greggdaug/hf_switch_matrix/hf_swmat_design_wb6yaz_041022.pdf

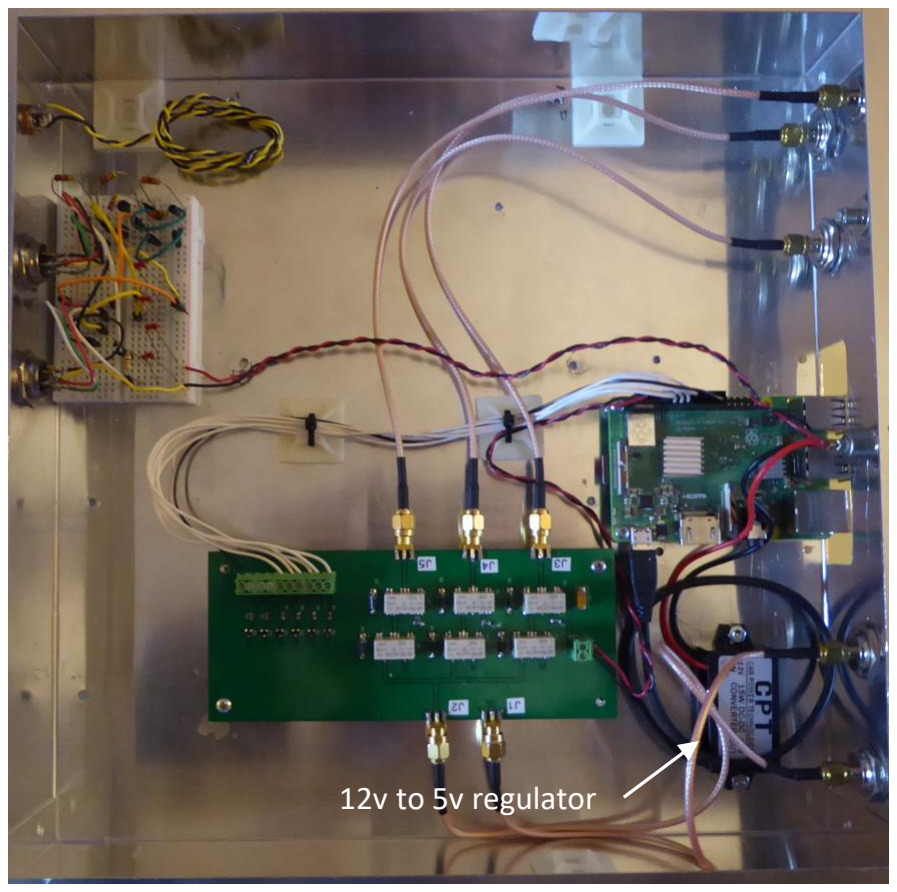
[picture p1: figure]
12v to 5v regulator

G. Daugherty – WB6YAZ | 4/10/22

Having three antennas and two HF rigs located in different parts of the house presented the opportunity to design a remote controlled switch matrix that would allow connecting any of the three antennas to the two rigs.

Described here is a 3:2 HF switch matrix controlled via a RasbperryPi 3B+. A rudimentary web server is used to allow control from a webpage.

The critical RF design criteria are VSWR, isolation and power handling. My two rigs are low power (<=100W) therefore the switch matrix was designed to handle 150W.

Six relays are mounted on a 4-layer FR4 PCB. PCBWay (https://www.pcbway.com/), a low cost PCB fab located in China was used to manufacture the PCB. To keep the cost low, the default 4-layer stackup was used. This resulted in acceptable VSWR at 30 MHz. Four layers were needed to implement ground layers between the two rig I/O ports. Two layers did not provide sufficient isolation.

## 100W 3:2 HF Switch Matrix

Figure 1 – Switch Matrix Enclosure

## 100W 3:2 HF Switch Matrix

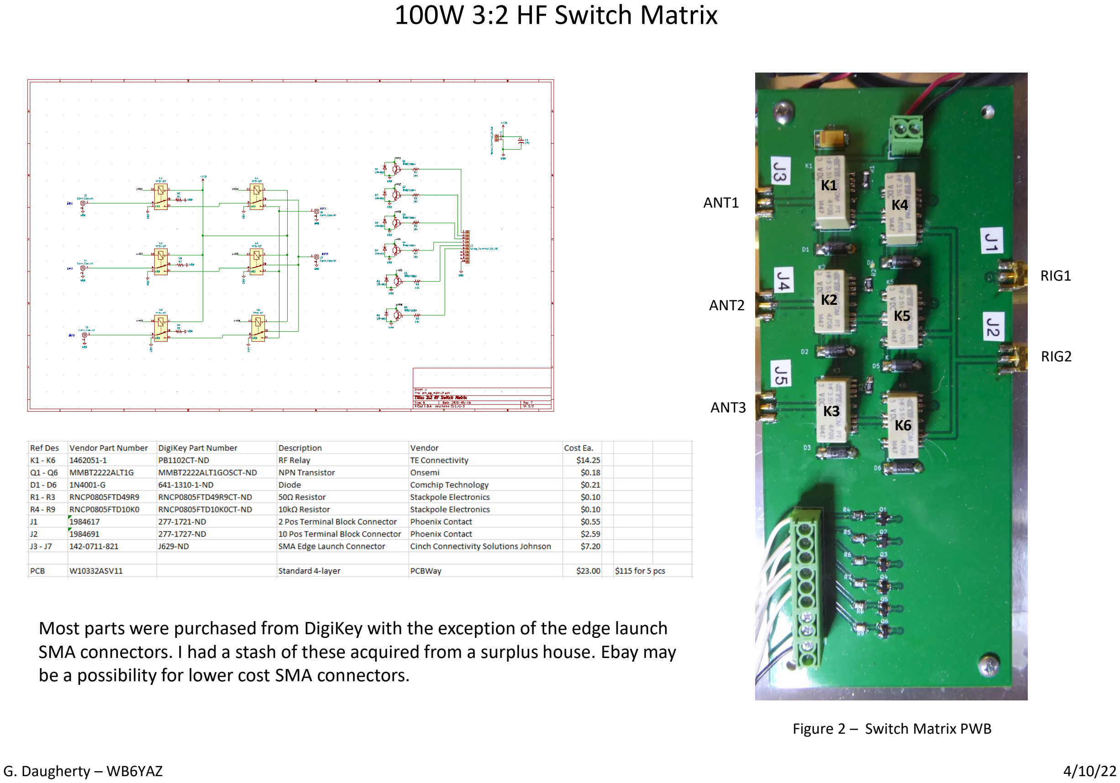
[picture p2: page 2]

K1

K2

K3

K4

K5

K6

ANT1

ANT2

ANT3

RIG1

RIG2

Most parts were purchased from DigiKey with the exception of the edge launch SMA connectors. I had a stash of these acquired from a surplus house. Ebay may be a possibility for lower cost SMA connectors.

Figure 2 – Switch Matrix PWB

## 100W 3:2 HF Switch Matrix

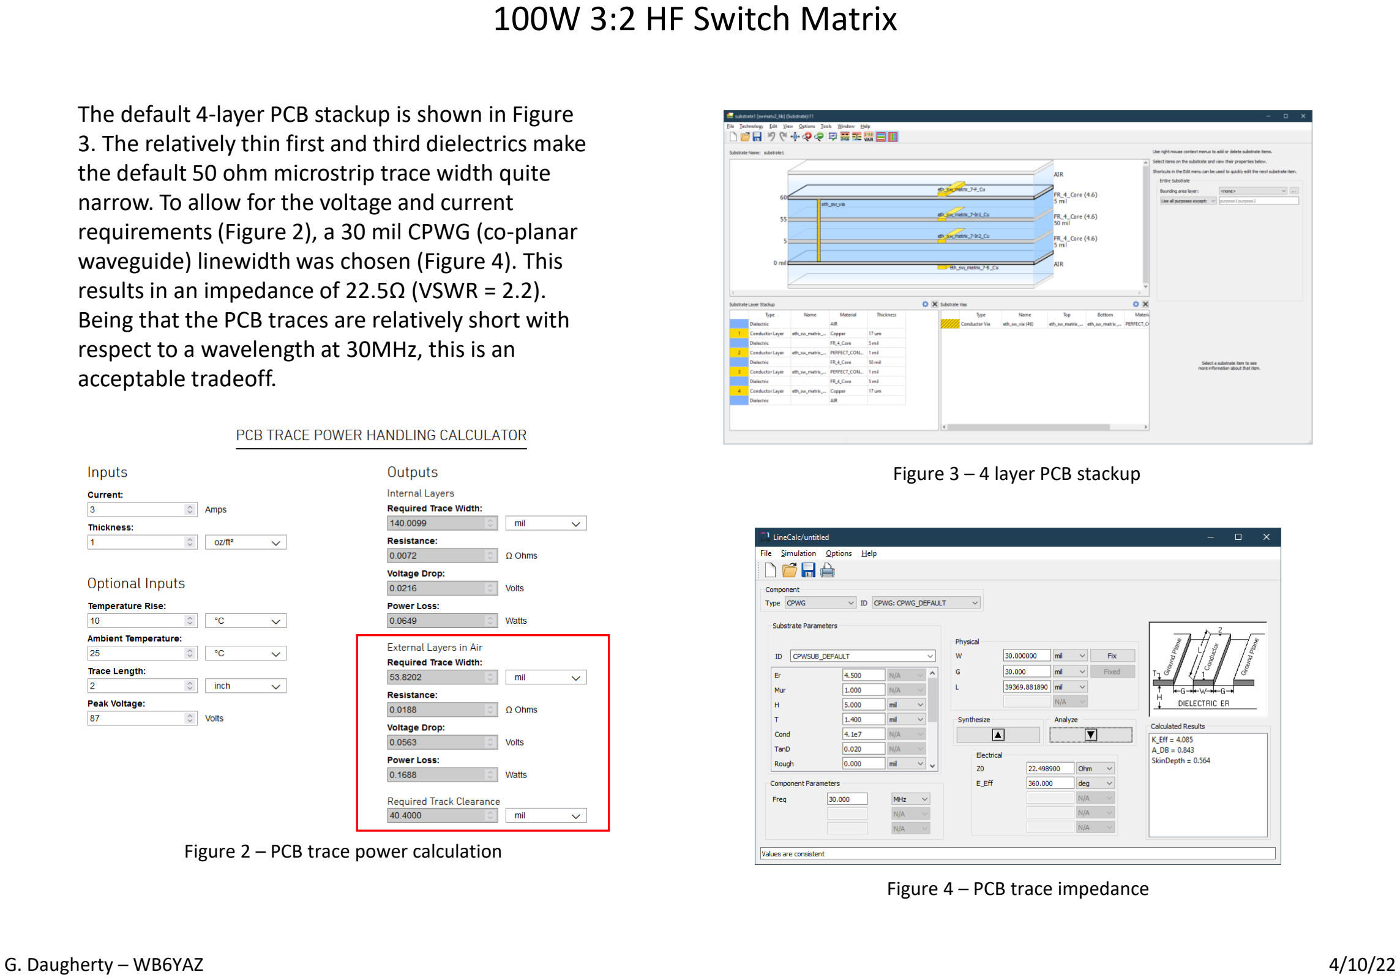
[picture p3: page 3]

The default 4-layer PCB stackup is shown in Figure
3. The relatively thin first and third dielectrics make the default 50 ohm microstrip trace width quite narrow. To allow for the voltage and current requirements (Figure 2), a 30 mil CPWG (co-planar waveguide) linewidth was chosen (Figure 4). This results in an impedance of 22.5Ω (VSWR = 2.2). Being that the PCB traces are relatively short with respect to a wavelength at 30MHz, this is an acceptable tradeoff.

Figure 3 – 4 layer PCB stackup

Figure 2 – PCB trace power calculation

Figure 4 – PCB trace impedance

The schematic / layout was first performed in KiCad, then the individual layers were imported into Keysight ADS where an EM (Keysight Momentum) simulation was performed to get a handle on the expected insertion loss and isolation.

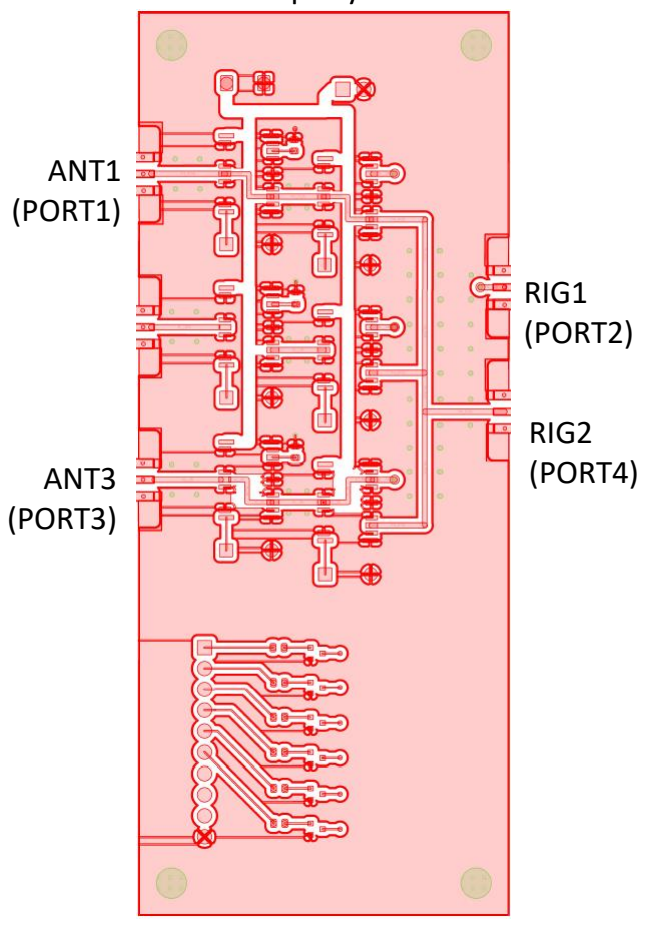
[picture p4: figure]
ANT3; (PORT4); (PORT3); RIG1 (PORT2)

ANT1
(PORT1)

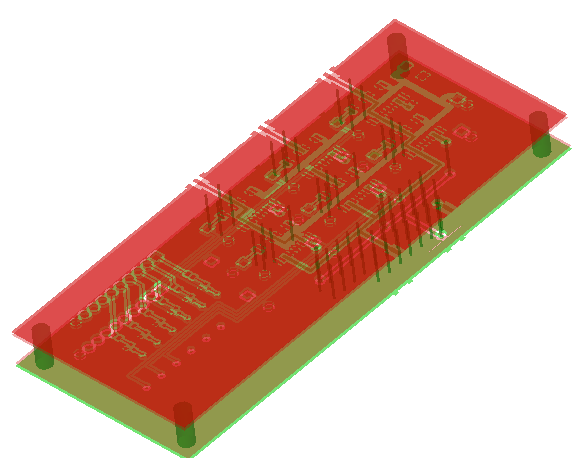
[picture p5: figure]

RIG2

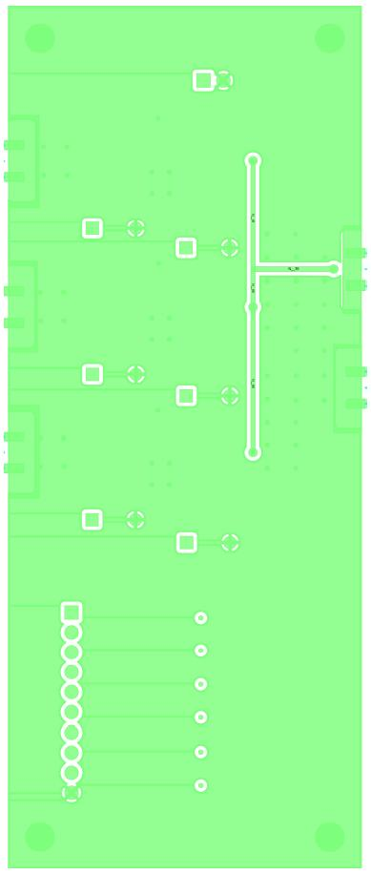
[picture p6: figure]

Figure 5 – PCB layout

## 100W 3:2 HF Switch Matrix

Top Layer | Bottom Layer

Keysight is very good at allowing experimenters 30 day trial licenses for projects such as this. The only issue with EM simulation is that it is very memory intensive. My computer setup consists of a 16GB i7 machine running Win10 Pro.

## 100W 3:2 HF Switch Matrix

EM simulation and measured results (Figure 6) show port VSWR below 1.5:1 and port to port isolation below 60dB @ 30 MHz.

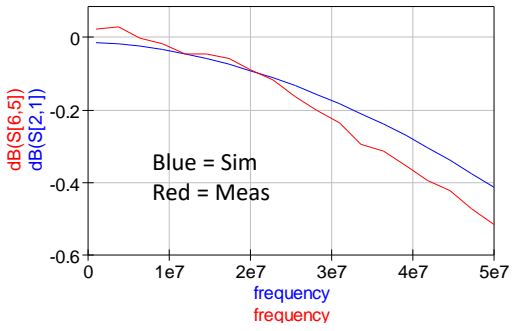
[picture p7: figure]
frequency frequency; Blue = Sim Red = Meas
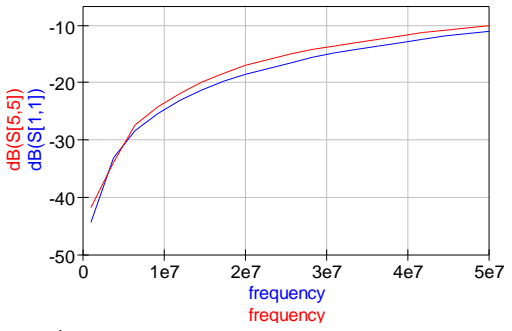
[picture p8: figure]
frequency frequency
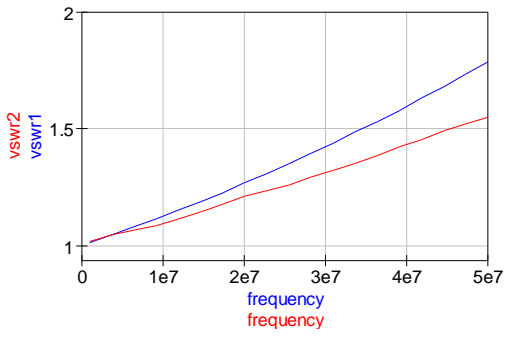
[picture p9: figure]
frequency frequency; vswr2; vswr1
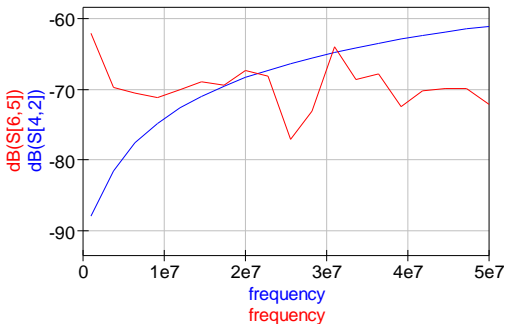
[picture p10: figure]
frequency frequency

Figure 6 – Simulation vs Measured Results

Ant1 to Rig1 Insertion Loss / Return Loss

Rig1 to Rig2 Isolation / VSWR

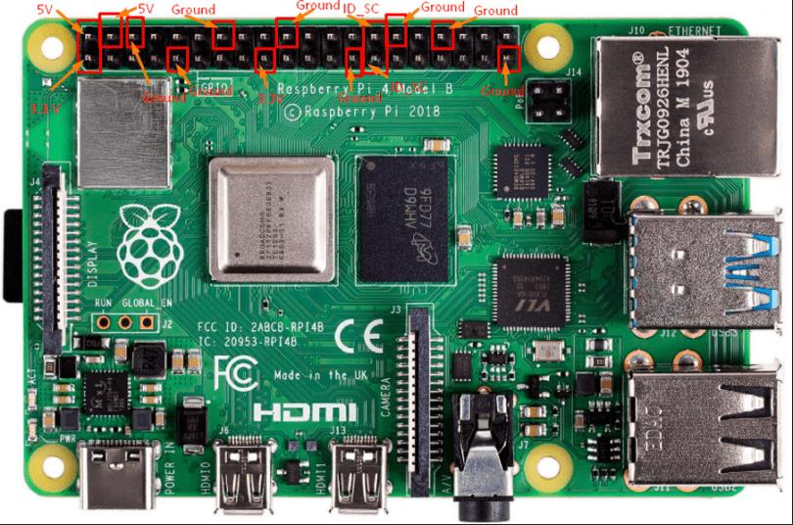
[picture p11: figure]

The Raspberry Pi GPIO outputs are 0 / 3.3V. The GPIOs used to control the relays are shown in Figure 7.

The standard Raspberry Pi OS is used to implement the control program.
(https://www.raspberrypi.com/software/operating-systems/). Using the version with desktop and (https://www.raspberrypi.com/software/operating-systems/) recommended software allows for implementing remote desktop and includes python3. Install ‘xrdp’ to utilize windows like remote desktop.

My setup uses the ethernet connection, the Raspberry Pi 3 also includes a WiFi option. WiFi setup can be configured via the raspi-config command line routine.

Flask is used to implement the webserver. Flask and xrdp can be installed via apt.
sudo apt-get install python3-flask
sudo apt-get install xrdp

## 100W 3:2 HF Switch Matrix

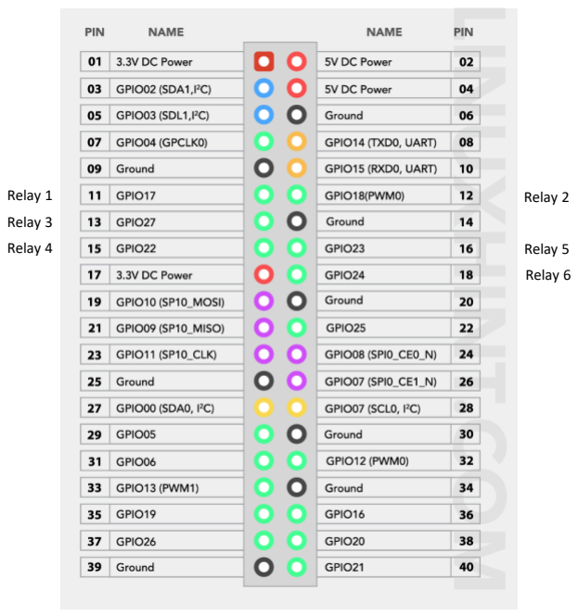
[picture p12: figure]
Relay 1; Relay 2; Relay 3; Relay 4; Relay 5; Relay 6

Figure 7 – Raspberry Pi GPIO pinout

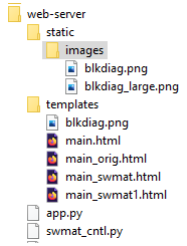
[picture p13: figure]

I have yet to master website design although have been become somewhat proficient in Python with the Raspberry Pi OS. Python has a simple web server package called Flask (https://pythonbasics.org/what-is-flask-python/).

With this package, It is quite easy to design a simple web server. The web server provides control of each of the relays by pressing the respective button. The webpage is initiated by inserting the IP address in a web browser.

## 100W 3:2 HF Switch Matrix

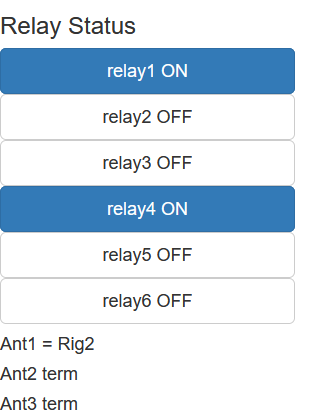
[picture p14: figure]
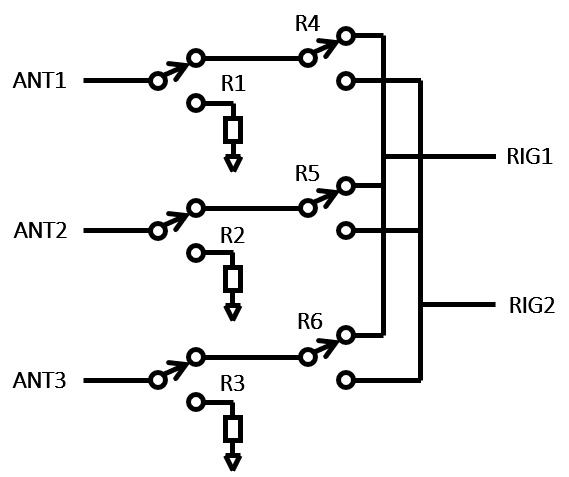
[picture p15: figure]

Figure 8– Flask Webpage

The Flask directory structure is shown in Figure 9. The server is initiated by running the command ‘sudo python3 swmat_cntl.py’ from the web-server directory.

All of the web server and KiCad files are available on my git hub page:

https://github.com/greggdaug/hf_switch_matrix

Figure 9 – Raspberry Pi Flask Directory Structure

## 100W 3:2 HF Switch Matrix

Conclusion:

The completed switch matrix performs well for power levels at 100W and below. It should be noted that at 100W (+50dBm), 60dB isolation would result in -10dBm at the alternate output. Therefore care must be taken to insure that a receiver connected to the alternate port is not overdriven. It is also recommended that switching should be initiated with the transmitters off.

I have not tested the switch matrix with antennas that present very high VSWRs. This may further limit the power output that could be used due to increased peak voltages. To alleviate this, automatic tuner(s) could be attached to the high VSWR antenna port(s).
