greggdaug/hf_switch_matrix/swmat_v7_bom.xlsx

Ref Des | Vendor Part Number | DigiKey Part Number | Description | Vendor | Cost Ea.
K1 - K6 | 1462051-1 | PB1102CT-ND | RF Relay | TE Connectivity | $14.25
Q1 - Q6 | MMBT2222ALT1G | MMBT2222ALT1GOSCT-ND | NPN Transistor | Onsemi | $0.18
D1 - D6 | 1N4001-G | 641-1310-1-ND | Diode | Comchip Technology | $0.21
R1 - R3 | RNCP0805FTD49R9 | RNCP0805FTD49R9CT-ND | 50Ω Resistor | Stackpole Electronics | $0.10
R4 - R9 | RNCP0805FTD10K0 | RNCP0805FTD10K0CT-ND | 10kΩ Resistor | Stackpole Electronics | $0.10
J1 | 1984617 | 277-1721-ND | 2 Pos Terminal Block Connector | Phoenix Contact | $0.55
J2 | 1984691 | 277-1727-ND | 10 Pos Terminal Block Connector | Phoenix Contact | $2.59
J3 - J7 | 142-0711-821 | J629-ND | SMA Edge Launch Connector | Cinch Connectivity Solutions Johnson | $7.20
PCB | W10332ASV11 |  | Standard 4-layer | PCBWay | $23.00 | $115 for 5 pcs
