greggdaug/hf_switch_matrix/gerber7/eth_sw_matrix_7-B_Cu.pdf

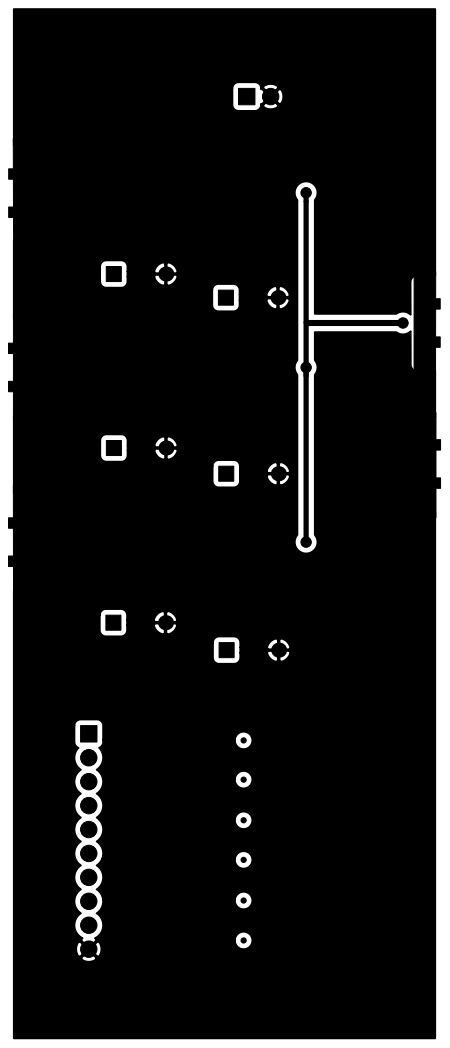
[picture p17: page 1]
