greggdaug/hf_switch_matrix/gerber7/eth_sw_matrix_7-B_Mask.pdf

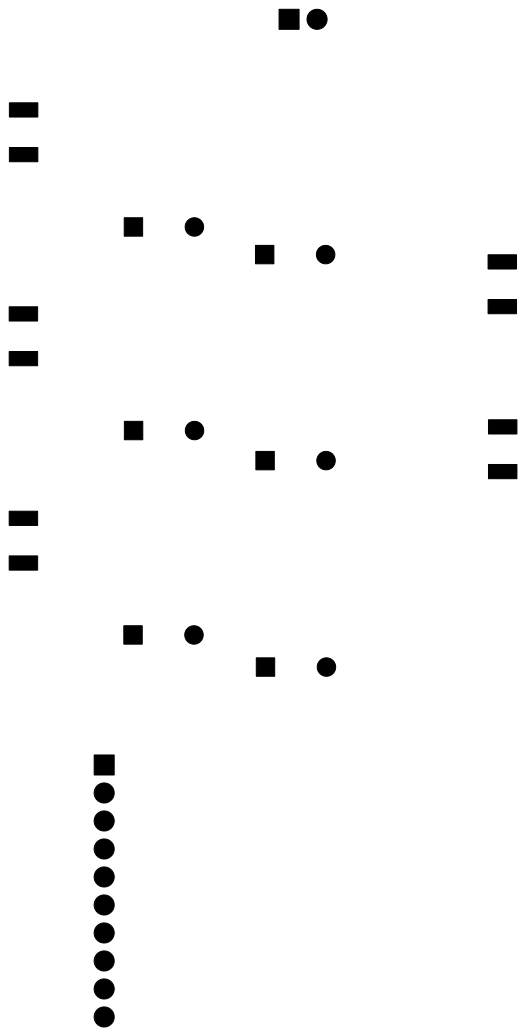
[picture p18: page 1]
