greggdaug/hf_switch_matrix/gerber7/eth_sw_matrix_7-F_Cu.pdf

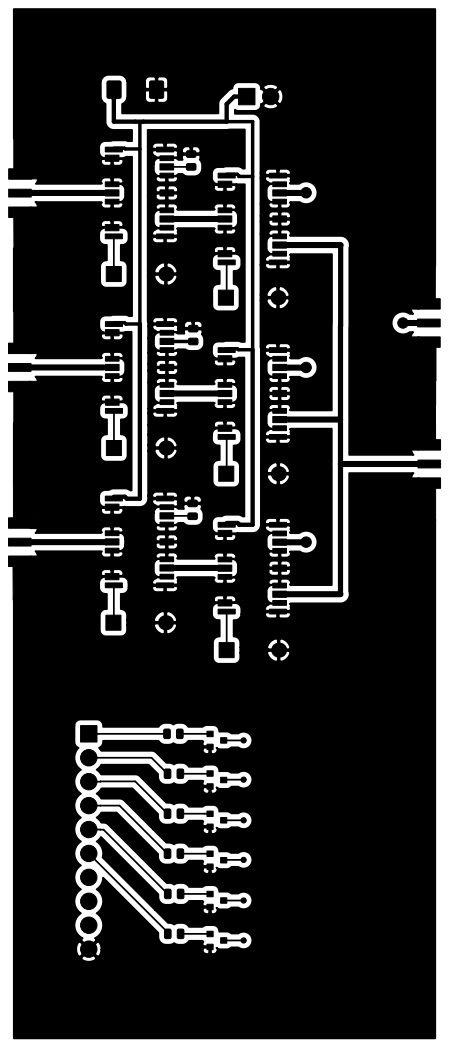
[picture p19: page 1]
