greggdaug/hf_switch_matrix/gerber7/eth_sw_matrix_7-F_Mask.pdf

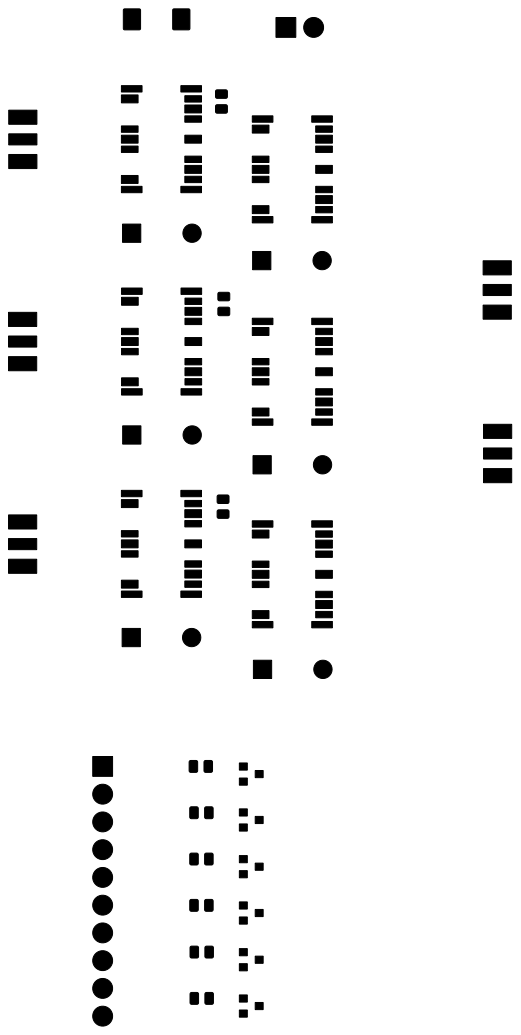
[picture p20: page 1]
