greggdaug/hf_switch_matrix/gerber7/eth_sw_matrix_7-F_SilkS.pdf

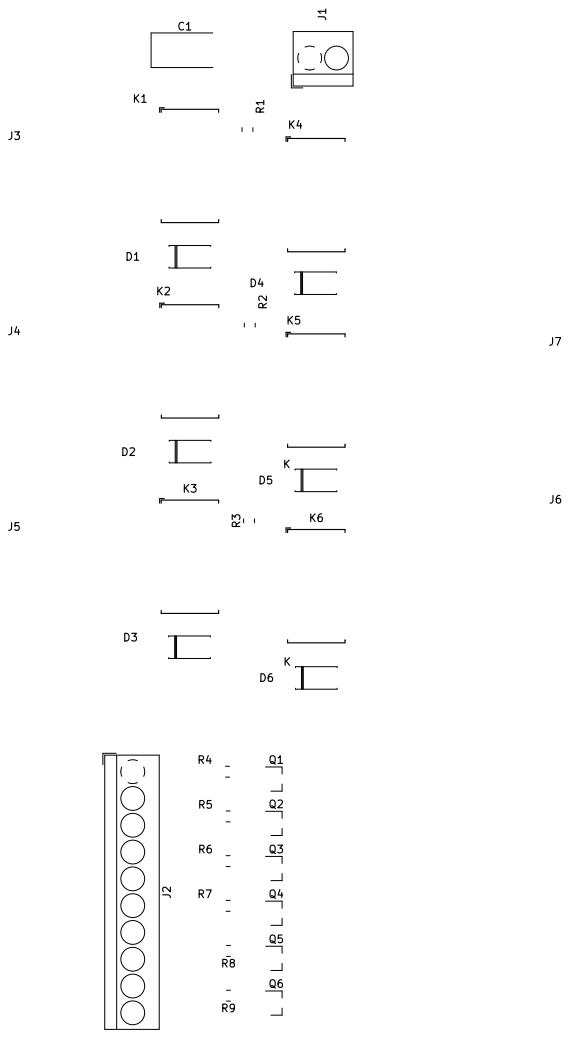
[picture p21: page 1]
