greggdaug/hf_switch_matrix/gerber7/eth_sw_matrix_7-In1_Cu.pdf

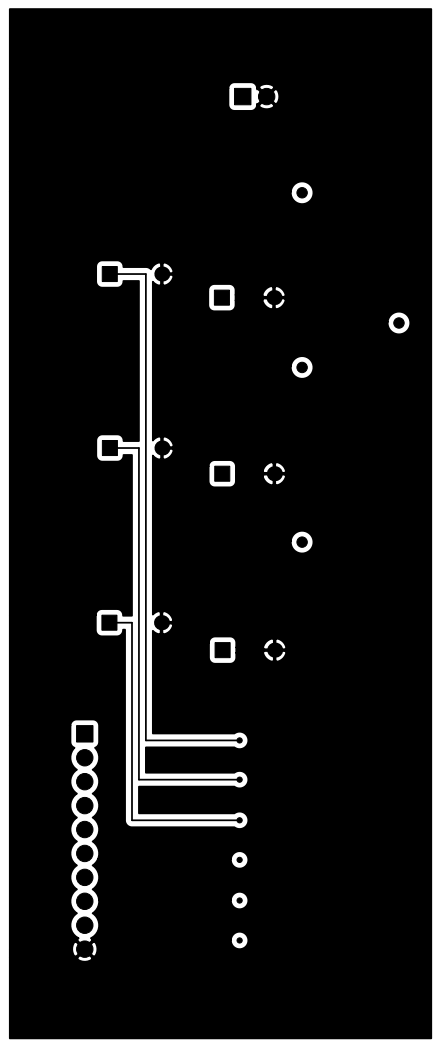
[picture p22: page 1]
