greggdaug/hf_switch_matrix/gerber7/eth_sw_matrix_7-In2_Cu.pdf

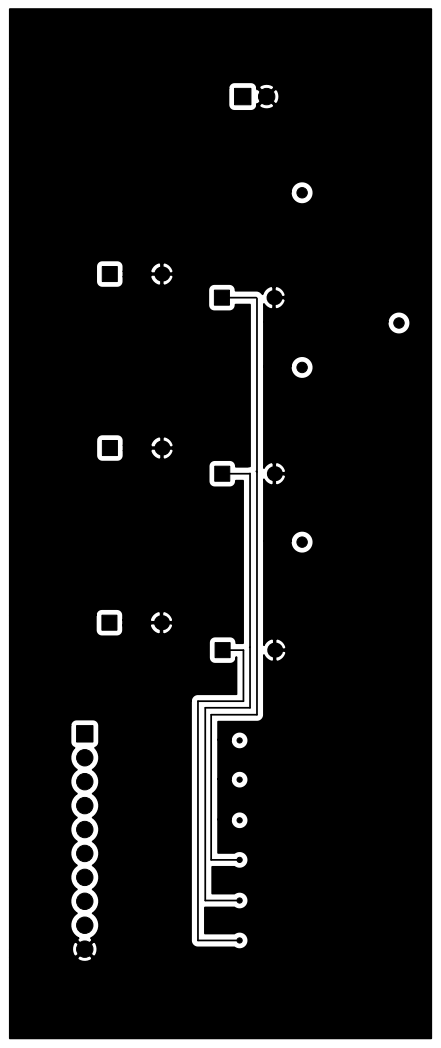
[picture p23: page 1]
