greggdaug/hf_switch_matrix/eth_sw_matrix_7.kicad_pcb

## KiCad design eth_sw_matrix_7.kicad_pcb (2022-03-02)

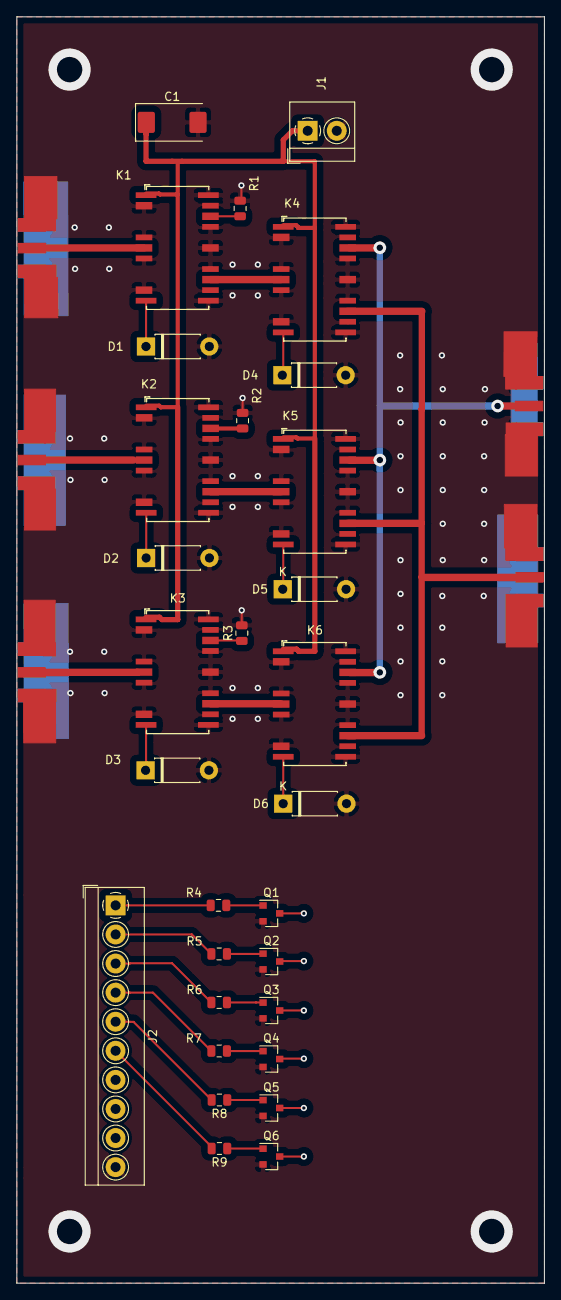
[picture p24: board eth_sw_matrix_7.kicad_pcb from above]

Board: 4 copper layers, 63.5 x 152.4 mm, 35 parts (0 on the bottom side), 31 nets.

Parts:
C1: CP1; CP_EIA-7343-30_AVX-N
D1, D2, D3, D4, D5, D6: SM4001; D_DO-41_SOD81_P7.62mm_Horizontal
J1: Screw_Terminal_01x02; TerminalBlock_4Ucon_1x02_P3.50mm_Horizontal
J2: Screw_Terminal_01x10; TerminalBlock_4Ucon_1x10_P3.50mm_Horizontal
J3, J4, J5, J6, J7: Conn_Coaxial; conn_sma_edgemnt
K1, K2, K3, K4, K5, K6: HF3-57; Relay_SPDT_AXICOM_HF3Series_50ohms_Pitch1.27mm
Q1, Q2, Q3, Q4, Q5, Q6: MMBT3904; SOT-23
R1, R2, R3: 50; R_0805_2012Metric
R4, R5, R6, R7, R8, R9: 10k; R_0805_2012Metric

Connections:
+12V: C1.1, J1.1, K1.1, K2.1, K3.1, K4.1, K5.1, K6.1
/cntl1: D1.1, K1.11, Q1.3
/cntl2: D2.1, K2.11, Q2.3
/cntl3: D3.1, K3.11, Q3.3
/cntl4: D4.1, K4.11, Q4.3
/cntl5: D5.1, K5.11, Q5.3
/cntl6: D6.1, K6.11, Q6.3
GND: C1.2, D1.2, D2.2, D3.2, D4.2, D5.2, D6.2, J1.2, J2.10, J3.2, J4.2, J5.2, J6.2, J7.2, K1.2, K1.5, K1.7, K1.10, K1.12, K1.13, K1.15, K1.17, K1.19, K1.21, K1.22, K2.2, K2.5, K2.7, K2.10, K2.12, K2.13, K2.15, K2.17, K2.19, K2.21, K2.22, K3.2, K3.5, K3.7, K3.10, K3.12, K3.13, K3.15, K3.17, K3.19, K3.21, K3.22, K4.2, K4.5, K4.7, K4.10, K4.12, K4.13, K4.15, K4.17, K4.19, K4.21, K4.22, K5.2, K5.5, K5.7, K5.10, K5.12, K5.13, K5.15, K5.17, K5.19, K5.21, K5.22, K6.2, K6.5, K6.7, K6.10, K6.12, K6.13, K6.15, K6.17, K6.19, K6.21, K6.22, Q1.2, Q2.2, Q3.2, Q4.2, Q5.2, Q6.2, R1.2, R2.2, R3.2
unnamed: J2.1, R4.2
unnamed: J2.2, R5.2
unnamed: J2.3, R6.2
unnamed: J2.4, R7.2
unnamed: J2.5, R8.2
unnamed: J2.6, R9.2
unnamed: J3.1, K1.6
unnamed: J4.1, K2.6
unnamed: J5.1, K3.6
unnamed: J6.1, K4.14, K5.14, K6.14
unnamed: J7.1, K4.20, K5.20, K6.20
unnamed: K1.14, K4.6
unnamed: K1.20, R1.1
unnamed: K2.14, K5.6
unnamed: K2.20, R2.1
unnamed: K3.14, K6.6
unnamed: K3.20, R3.1
unnamed: Q1.1, R4.1
unnamed: Q2.1, R5.1
unnamed: Q3.1, R6.1
unnamed: Q4.1, R7.1
unnamed: Q5.1, R8.1
unnamed: Q6.1, R9.1
